GuybrushTreep/Flick-Out/src/Flick-Out/data/boot.gif

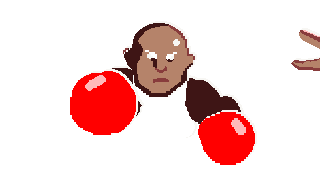
src/Flick-Out/data/boot.gif
