GuybrushTreep/Flick-Out/src/Flick-Out/data/fight.gif

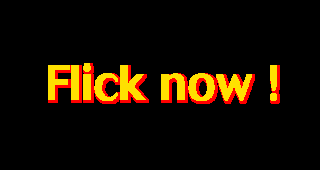
src/Flick-Out/data/fight.gif
