GuybrushTreep/Flick-Out/src/Flick-Out/data/highScore.gif

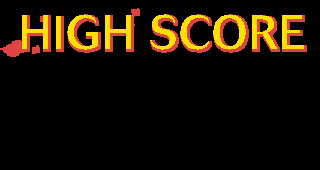
src/Flick-Out/data/highScore.gif
