GuybrushTreep/Flick-Out/src/Flick-Out/data/idle.gif

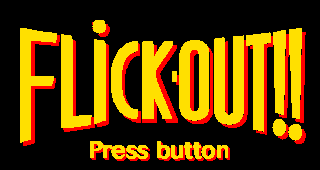
src/Flick-Out/data/idle.gif
