GuybrushTreep/Flick-Out/src/Flick-Out/data/start.gif

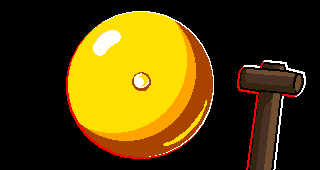
src/Flick-Out/data/start.gif
