GuybrushTreep/Flick-Out/assembly/FlickOut_Assembly.pdf

Lilygo T-Dispay S3 X1 (https://lilygo.cc/products/t-display-s3) | DF Mini Player X1 (https://www.dfrobot.com/product-1121.html) | SD card (max 32 GB) X1 | NeoPixel Stick X1 (https://www.adafruit.com/product/2868) | Speaker 40mm X1 (https://www.amazon.com/a15112300ux1550-Diameter-Internal-Speaker-Loudspeaker/dp/B01BB4YMCU) | Lipo 1s 1000 mah (https://www.amazon.com/083040-1000mAh-Polymer-Battery-Rechargeable/dp/B06WRRQGR6)
Dupont Jumper Wires (https://www.amazon.com/California-JOS-Breadboard-Optional-Multicolored/dp/B0BRTKTV64) | Push Button (https://www.amazon.com/DAOKI-Miniature-Momentary-Tactile-Quality/dp/B01CGMP9GY) | 47K resistor X1 (https://www.amazon.com/EDGELEC-Resistor-Tolerance-Multiple-Resistance/dp/B07QJB1Q7D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) | SS12F15 X1 (https://www.amazon.com/Tnuocke-Vertical-Position-Latching-SS12F15-G5/dp/B099N3HFPG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) | BT8X2 self tapping (https://eu.store.bambulab.com/fr/products/bt2-socket-head-cap-self-tapping-screws-shcs) | M2X8 screws | FSR Force sensor (https://www.amazon.com/Haosie-Pressure-Sensitive-Resistance-Detection/dp/B0C74RP48B)
female to female | 6X6X5 X1 | | | Screws X10 | and Nuts X2 | 0-30 Kg X1

10X5X4 ball bearing X2 (https://www.amazon.com/Miniature-Skateboard-Bearings-MR105ZZ-L-1050ZZ/dp/B00ZHSTKCE)

# https://github.com/GuybrushTreep/Flick-Out

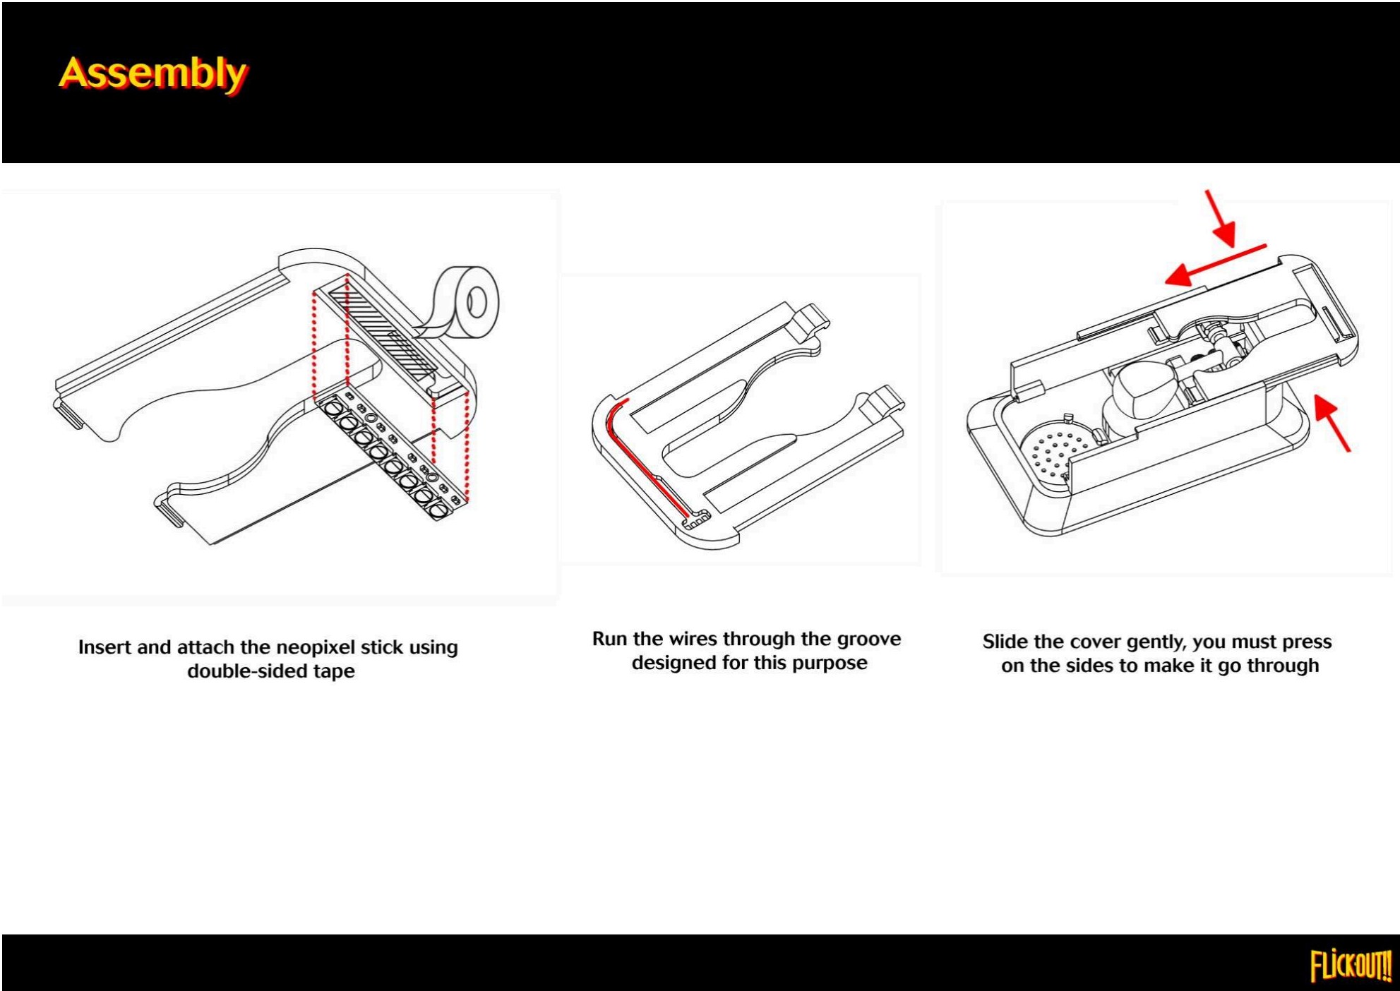
[picture p9: page 13]
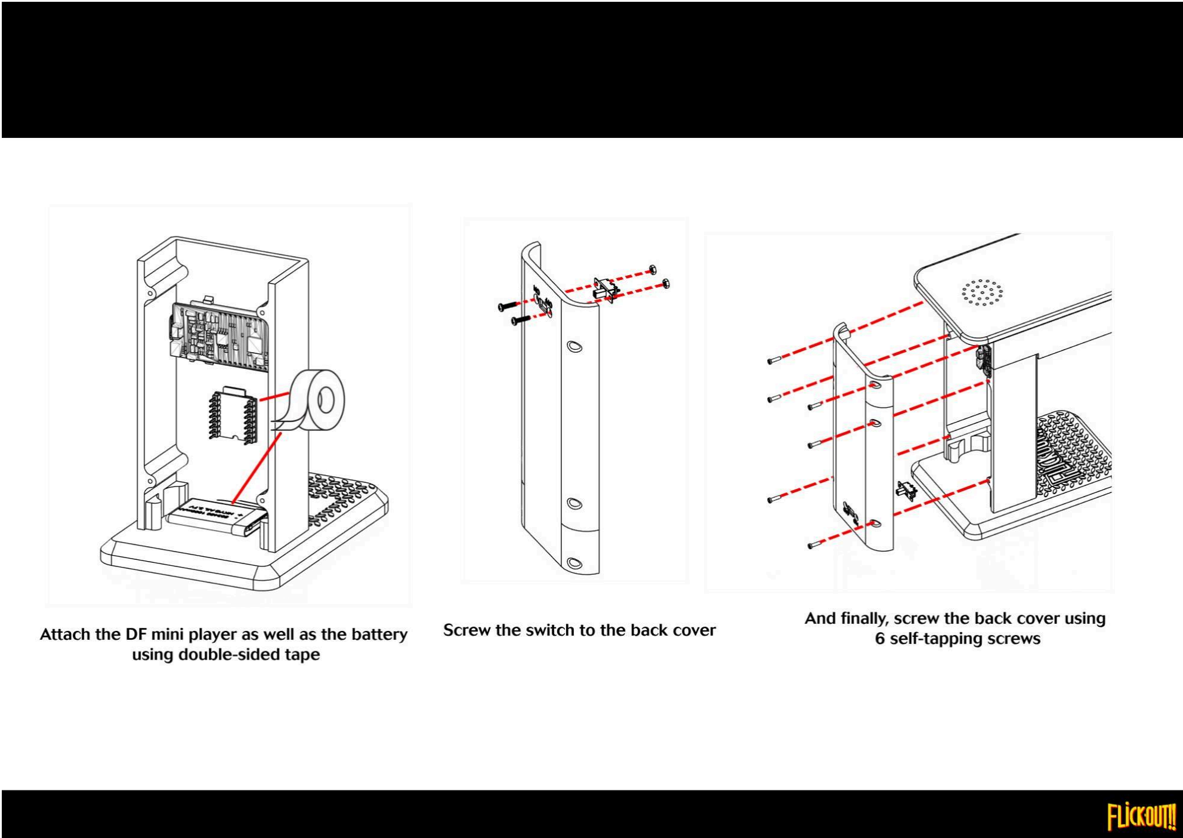
[picture p10: page 14]
