GuybrushTreep/Flick-Out/(threads)

Thread 1 (2025-07-13):

Partitioning Scheme documentation and incorrect serial pins for DFPlayer

chornbec, 2025-07-13:
**TL;DR** for users experiencing `LittleFS Failed` or mp3 files / sound not playing, check the **Resolution** sections for each problem.

This project is great, but I've noticed a couple of areas that could be improved. We should add the following to the Troubleshooting section and update the code with correct pins.

## Partitioning Scheme
This issue may not be unique to Flick-Out, but more likely the LilyGo T-Display-S3 devices.
### Problem
Receiving `LittleFS Failed` on LilyGo display or `Partition entry not found in csv!` in Arduino IDE output
### Resolution
1. Go to `Tools > Partition Schemes` in the Arduino IDE. Note the selected scheme (it might be `16MB Flash (3MB APP/9.9MB FATFS)`) if you selected `LilyGo T-Display-S3` for your board.
2. Locate the csv file that represents the scheme (Windows: `C:\Users\{YourUserName}\AppData\Local\Arduino15\packages\esp32\hardware\esp32\{version}\tools\partitions`, Others: `~/Library/Arduino15/packages/esp32/hardware/esp32/{version}/tools/partitions`). It should be `app3M_fat9M_16MB.csv`.
3. I recommend editing it to the below. This comes from a different partition scheme file I copied after seeing which other board selection has a scheme that works with spiffs/littlefs:
```
# Name,   Type, SubType, Offset,  Size, Flags
nvs,      data, nvs,     0x9000,  0x5000,
otadata,  data, ota,     0xe000,  0x2000,
app0,     app,  ota_0,   0x10000, 0x140000,
app1,     app,  ota_1,   0x150000,0x140000,
spiffs,   data, spiffs,  0x290000,0x160000,
coredump, data, coredump,0x3F0000,0x10000,
```
4. Save the file. You may need to clear your cache by removing the `arduino-ide` directory (Windows: `C:\Users\[user_name]\AppData\Roaming\arduino-ide\`, Other: `~/Library/Application Support/arduino-ide`).
5. Re-run the LittleFS addon tool. It should fix the `Partition entry not found in csv!` error.
6. Re-upload the Flick-Off script to the device. This should fix the `LittleFS Failed` error.

### Explanation
The LittleFS addon for the Arduino IDE is used to upload the gif files to flash. The addon supports `spiffs` file system, not `fatfs`, and since the LilyGo T-Display-S3 board from version <=2.0.17 of the esp32 board library by expressif doesn't seem to have partition schemes with `spiffs`, you have to get fancy by overwriting one of them. I'm sure there's some other boards (like the `ESP32S3 Dev Module` that the LilyGo team recommends) that support spiffs, but I've had issues uploading code with those boards.
So essentially, the above schema file should work for both the Upload function and Upload LittleFS function.

## Incorrect serial pins for DFPlayer
### Problem
You get a black screen, and the Serial Monitor tells you `Please recheck the connection!`. Or, the device shows gifs but doesn't output sound.
### Solution
I haven't dug into this as much, but I had to replace the following [code](https://github.com/GuybrushTreep/Flick-Out/blob/main/src/Flick-Out/Flick-Out.ino#L262)...
```
// HardwareSerial FPSerial(2);  <---- delete this
#define FPSerial Serial1 // <---- add this
DFRobotDFPlayerMini myDFPlayer;
```
as well as changing 3 Pins from [here](https://github.com/GuybrushTreep/Flick-Out/blob/main/src/Flick-Out/Flick-Out.ino#L57) to this instead:
```
#define EXTERNAL_BUTTON_PIN 21 // <--- change to 21
#define BATTERY_PIN 4
#define RXD2 18 // <--- change to 18
#define TXD2 17 // <--- change to 17
```
### Explanation
The LilyGo hardware serial pins are 18 for RX and 17 for TX. Not sure why this project says to use 21 and 16...
I removed the `HardwareSerial` line because I think it's redundant if you use `Serial1`, which is the Hardware Serial port name.

GuybrushTreep, 2025-07-15:
Hello @chornbec ,
Thanks a lot for the time you spent troubleshooting my poorly documented project 👍
Here is the config i'm using for the partition scheme that seems to work :

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

I'm not using the lilygo-T-display-S3 but the lilygo-T3-S3 instead as my main board, wich supports spiffs. It's totally an error on my side, but a lucky one as i had no issue uploading the files with the default partition.

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

Regarding pins for DFplayer mini, well, i'm not sure why it's working on my side, i'll upload the documentation with your solution.
