GuybrushTreep/Flick-Out/(commit log)

2025-06-29 Fixing schematics error for FSR wiring
2025-06-29 Update Schematics
2025-07-15 add boardSettings.png
