GuybrushTreep/Flick-Out/(notices)

Notices in the files:
README.md:
License: MIT
